Bdg9/RoboticsJawArduino/report/Conclusion.tex

\section{Conclusion}

This project presented the design and development of a novel chewing robot capable of reproducing jaw motions using a Stewart platform. 
The mechanical design, control system, and data processing pipeline were developed with scalability and modularity in mind, laying the 
groundwork for a more complete biomimetic mastication system.

The robot successfully replicates simplified human jaw trajectories using motion capture data and demonstrates the ability to generate average chewing forces. 
The inclusion of force sensing enables 3D distributed force feedback and basic safety mechanisms.
The modular control system and mechanical design allow for future integration of additional features, such as a tongue, saliva 
module, or esophagus.

Despite these achievements, the robot in its current form is not yet capable of full chewing functionality. Limitations in mechanical compliance, 
control accuracy, sensing precision, and teeth design prevent accurate and robust reproduction of natural mastication. Additionally, the current 
motion capture methodology introduces errors that limit the fidelity of recorded trajectories.

Nonetheless, the system serves as a strong foundation for future work. Improvements in control strategy, sensing, compliance, and anatomical 
fidelity—combined with more accurate motion datasets—will enable the robot to more closely replicate the biomechanics of human chewing.
