Bdg9/RoboticsJawArduino/plots_generation/actuator_rms_errors.png

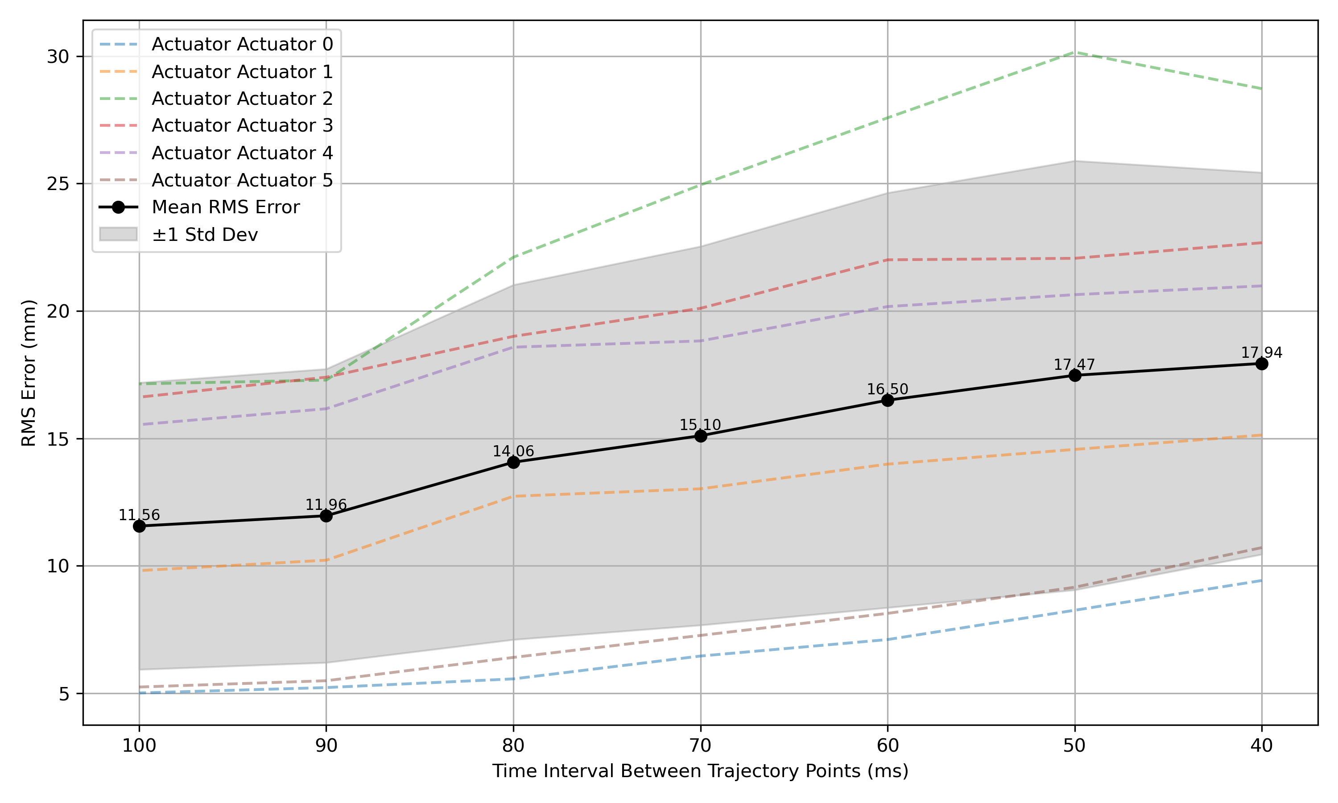
plots_generation/actuator_rms_errors.png
