Bdg9/RoboticsJawArduino/plots_generation/trajectory_plot_before.png

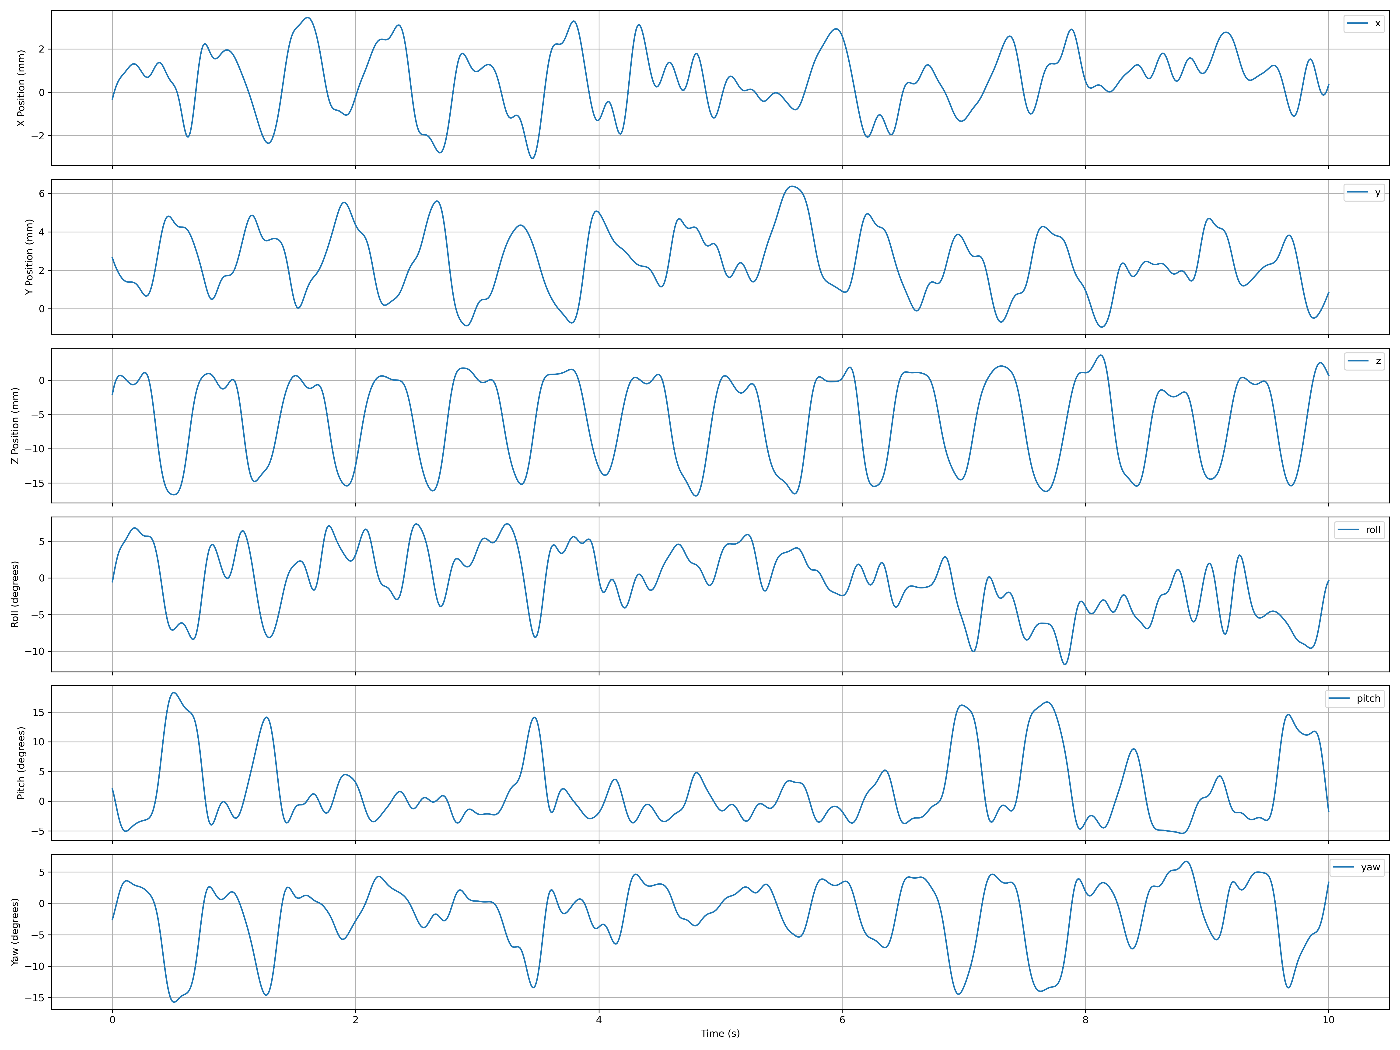
plots_generation/trajectory_plot_before.png
