Bdg9/RoboticsJawArduino/report/figures/6dof_jaw.jpg

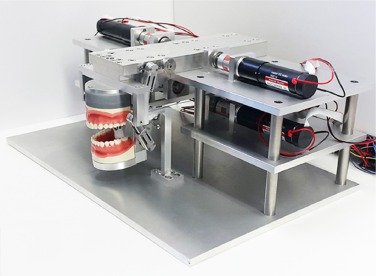
report/figures/6dof_jaw.jpg
