Bdg9/RoboticsJawArduino/report/figures/actuator_1_trajectories.png

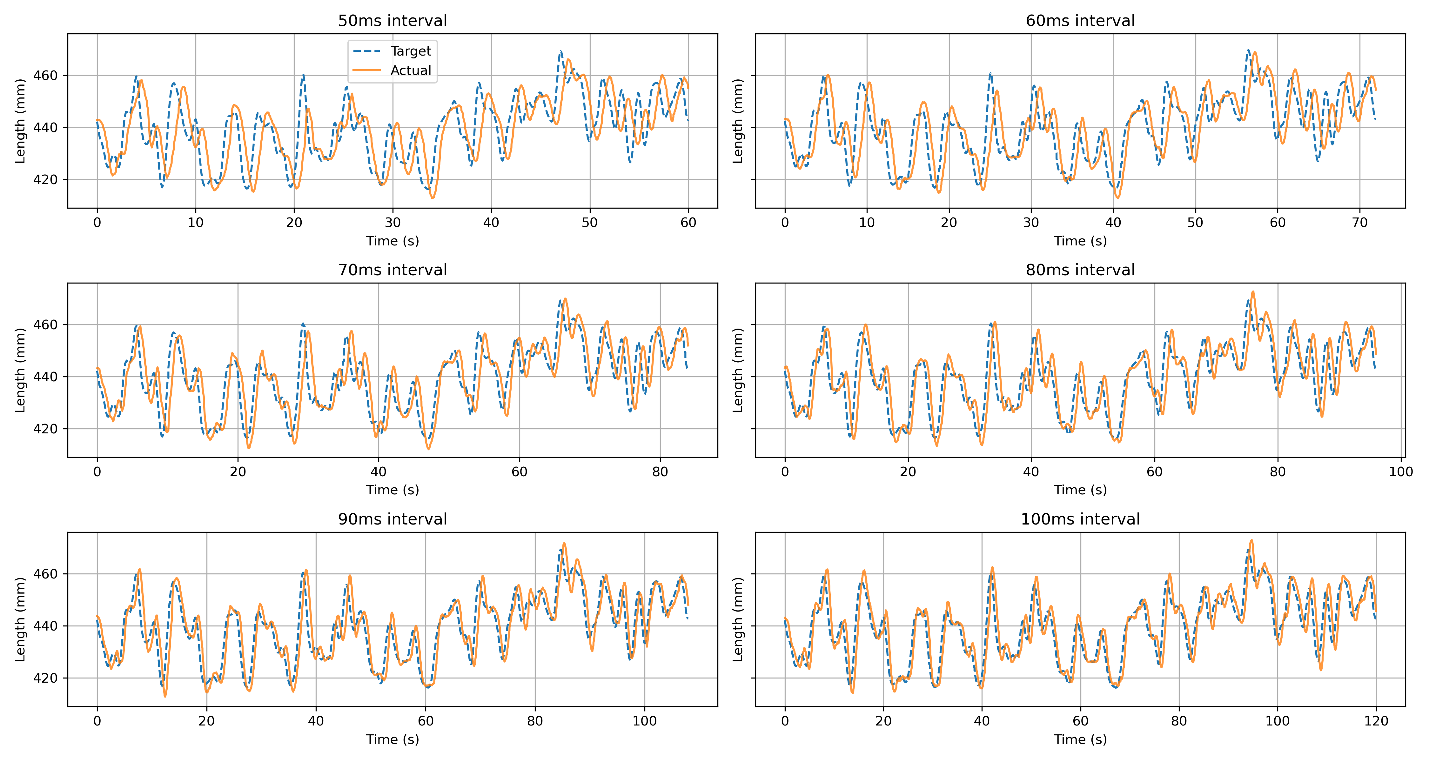
report/figures/actuator_1_trajectories.png
