Bdg9/RoboticsJawArduino/report/figures/actuator_4_trajectories.png

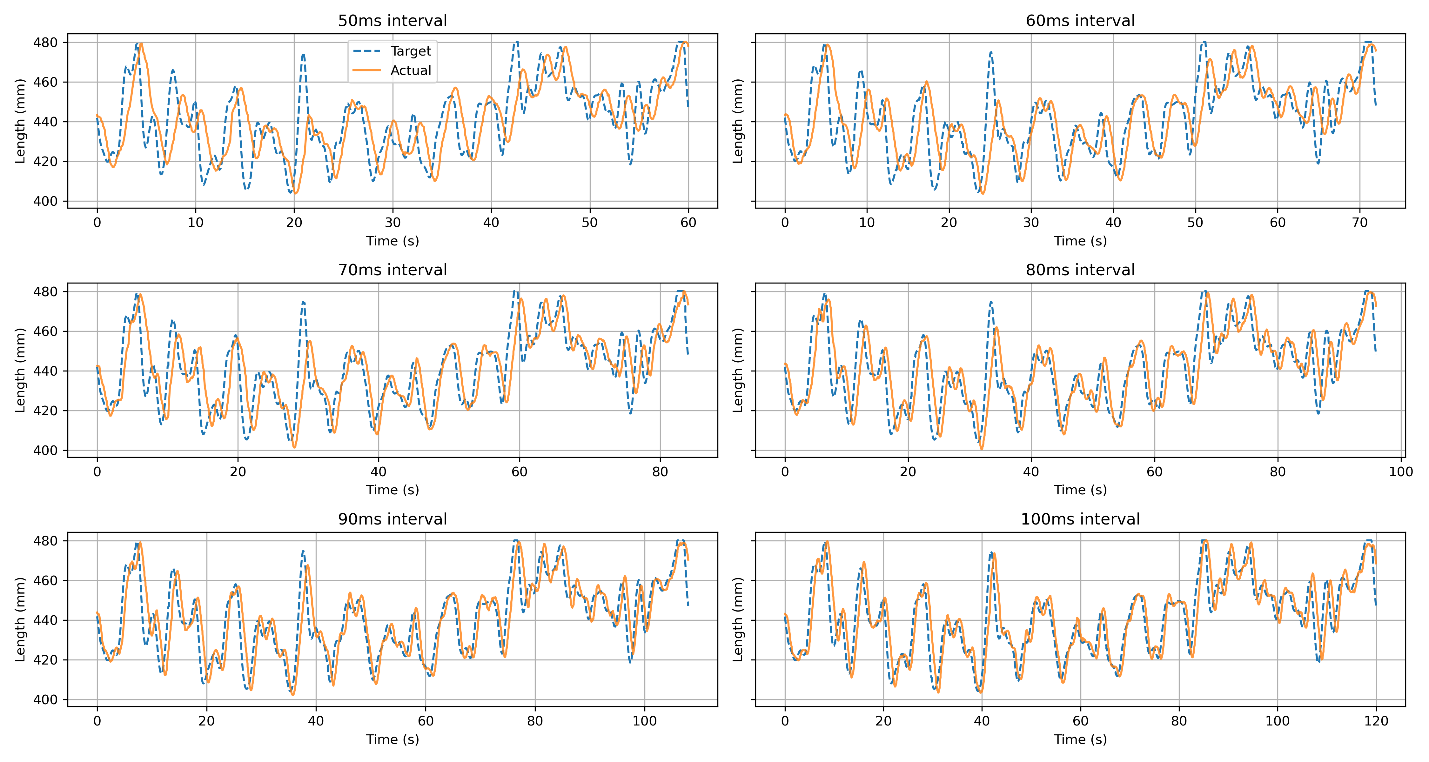
report/figures/actuator_4_trajectories.png
