Bdg9/RoboticsJawArduino/report/figures/actuator_5_trajectories.png

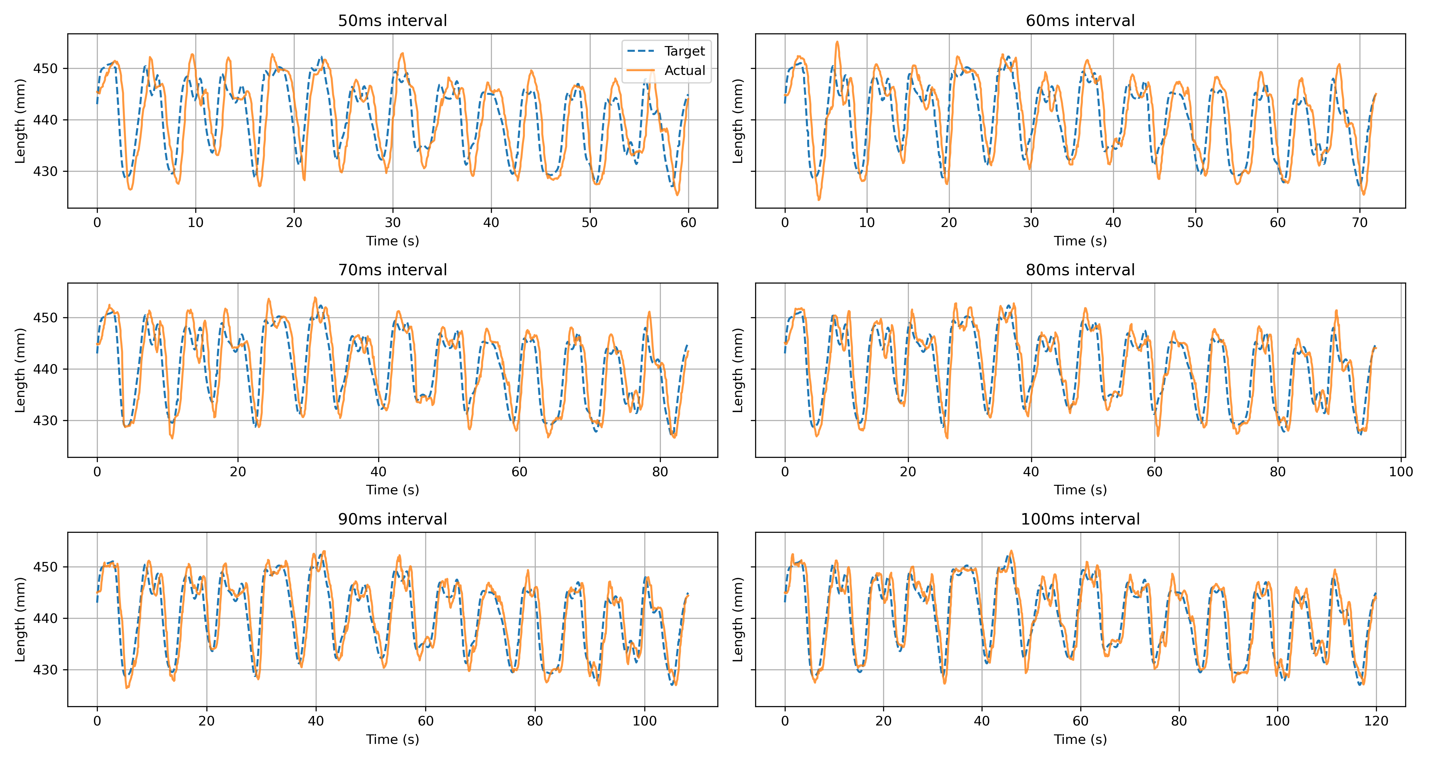
report/figures/actuator_5_trajectories.png
