Bdg9/RoboticsJawArduino/report/figures/ForceDistribution2.png

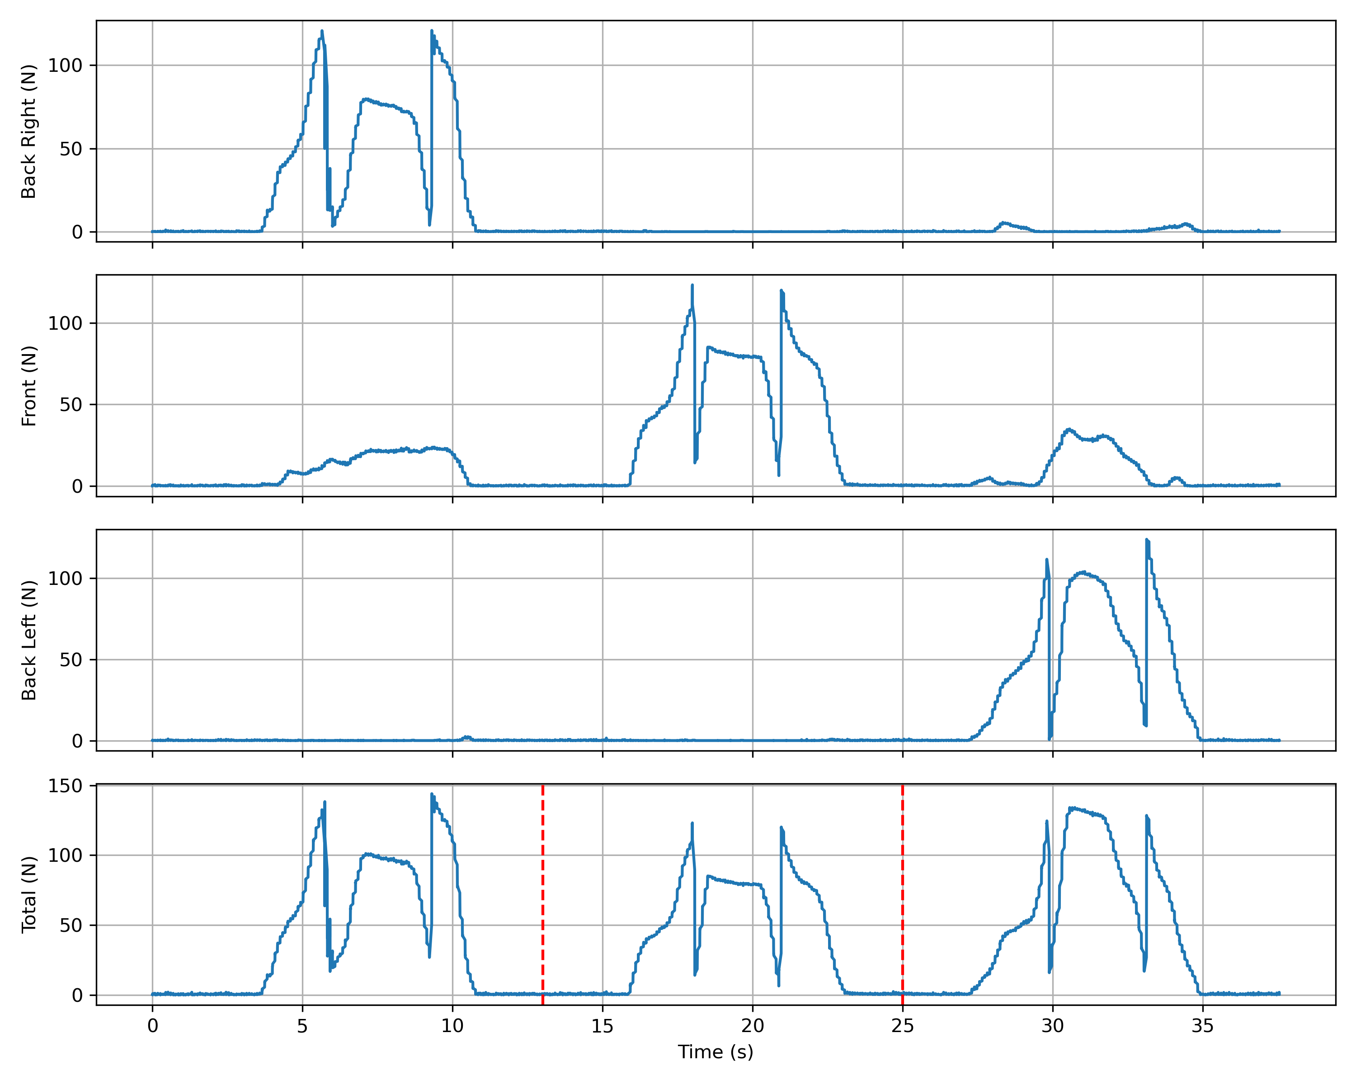
report/figures/ForceDistribution2.png
