Bdg9/RoboticsJawArduino/report/figures/ForceDistribution.png

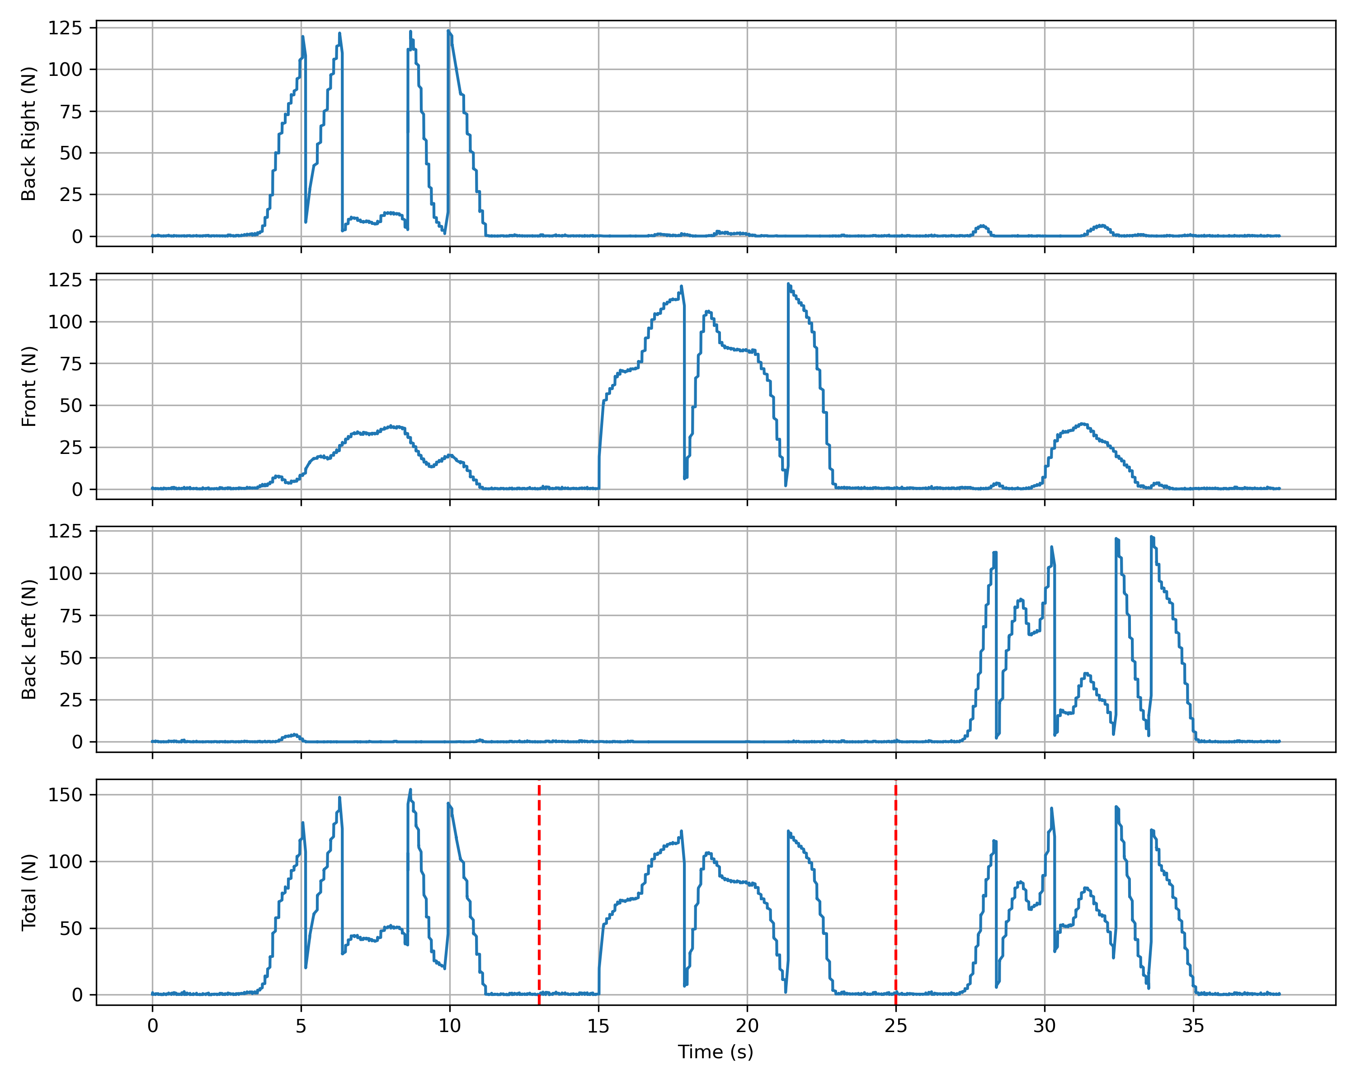
report/figures/ForceDistribution.png
