Bdg9/RoboticsJawArduino/report/figures/ForceDistribution_tpu.png

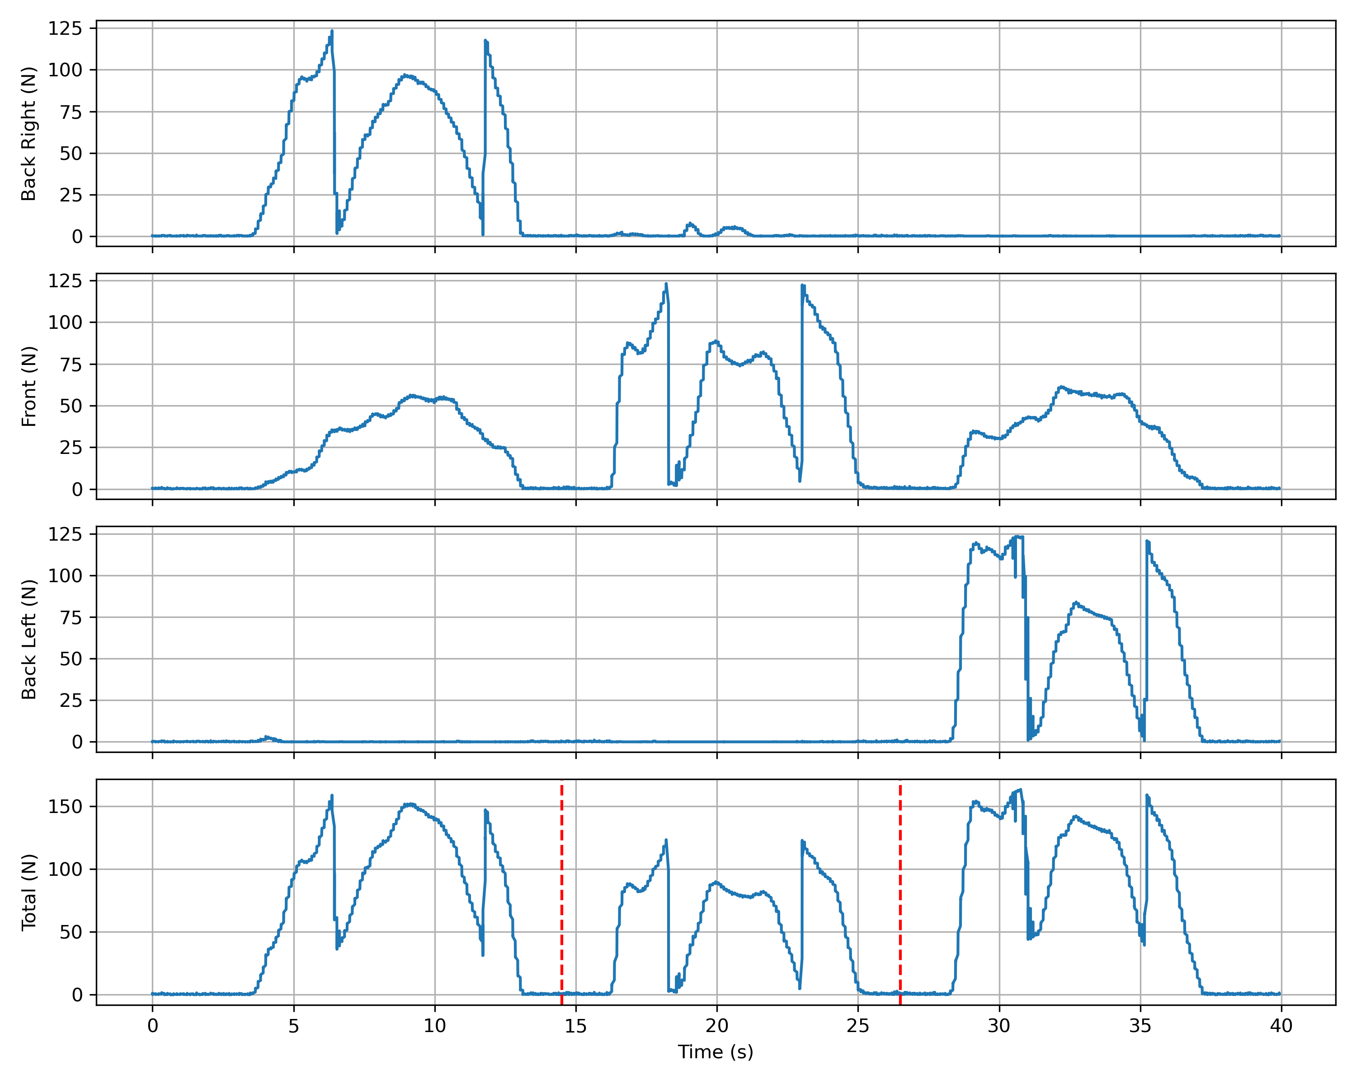
report/figures/ForceDistribution_tpu.png
