Bdg9/RoboticsJawArduino/report/figures/linear_stewart_platform.png

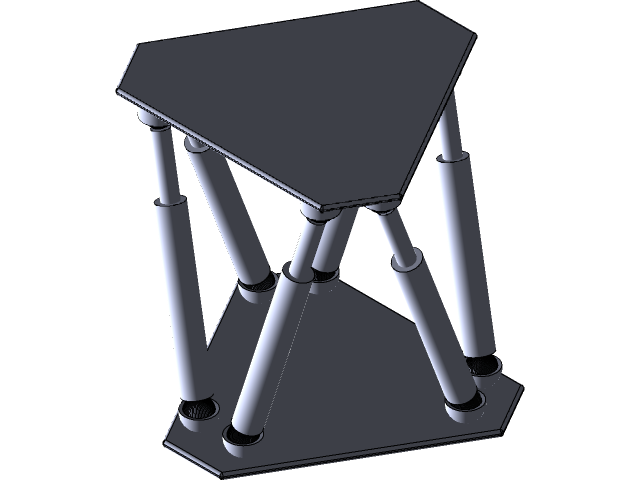
report/figures/linear_stewart_platform.png
