Bdg9/RoboticsJawArduino/report/figures/lower_jaw.png

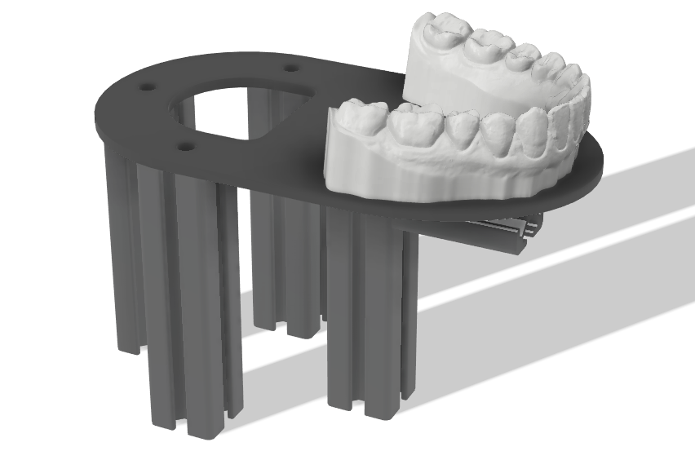
report/figures/lower_jaw.png
