Bdg9/RoboticsJawArduino/report/figures/upper_jaw.png

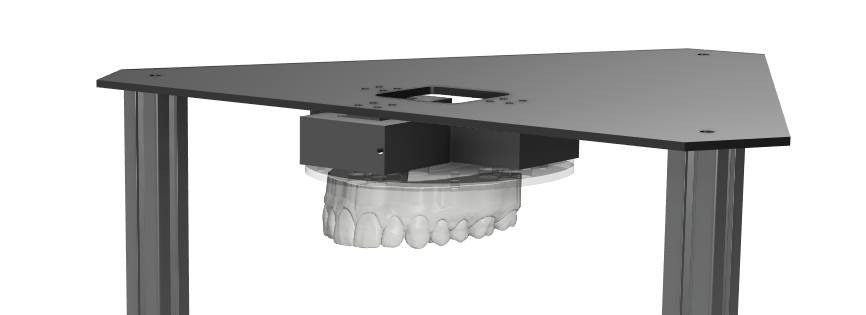
report/figures/upper_jaw.png
