Bdg9/RoboticsJawArduino/report/figures/upper_jaw_close_up.png

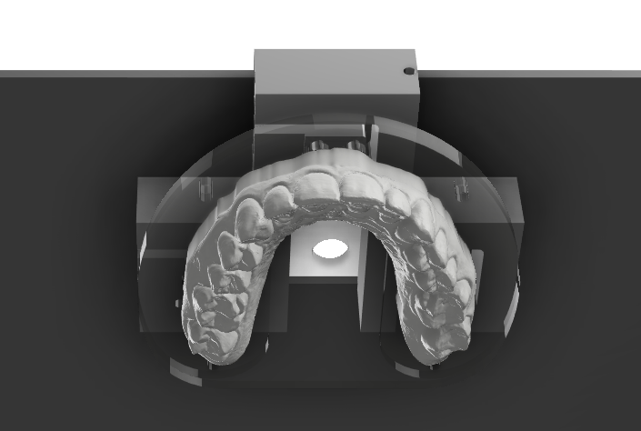
report/figures/upper_jaw_close_up.png
