Bdg9/RoboticsJawArduino/report/figures/x_vs_z_position.png

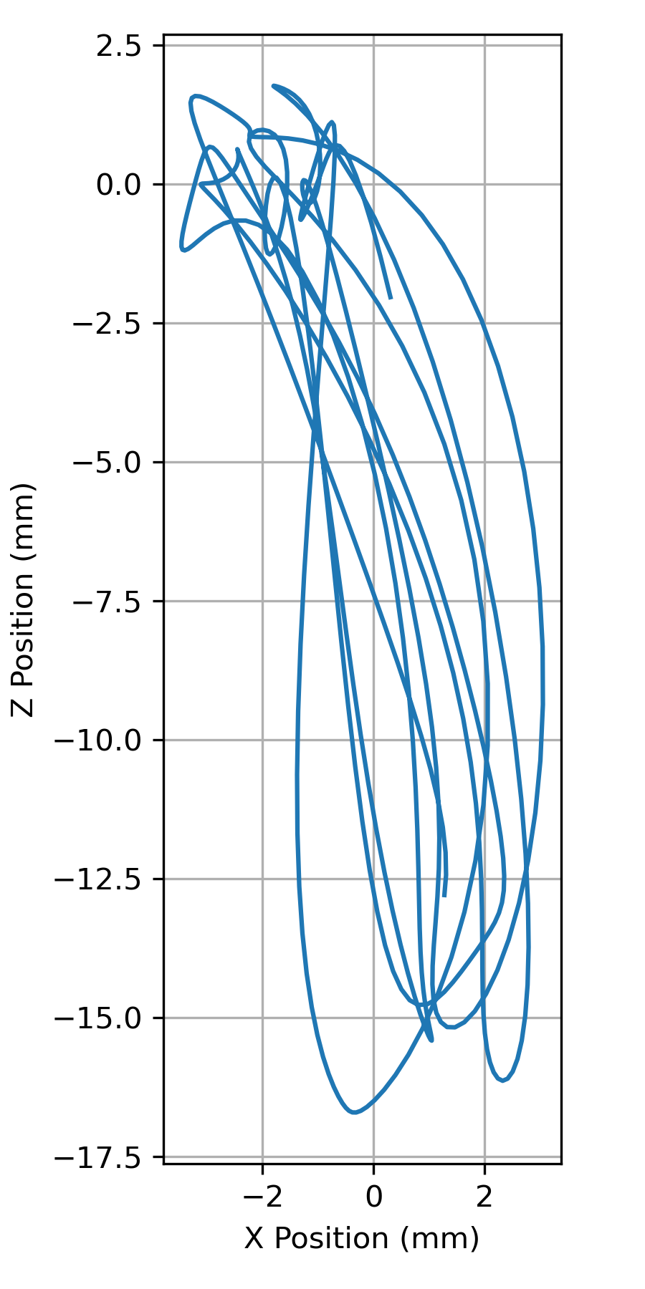
report/figures/x_vs_z_position.png
