Bdg9/RoboticsJawArduino/report/figures/y_vs_z_position.png

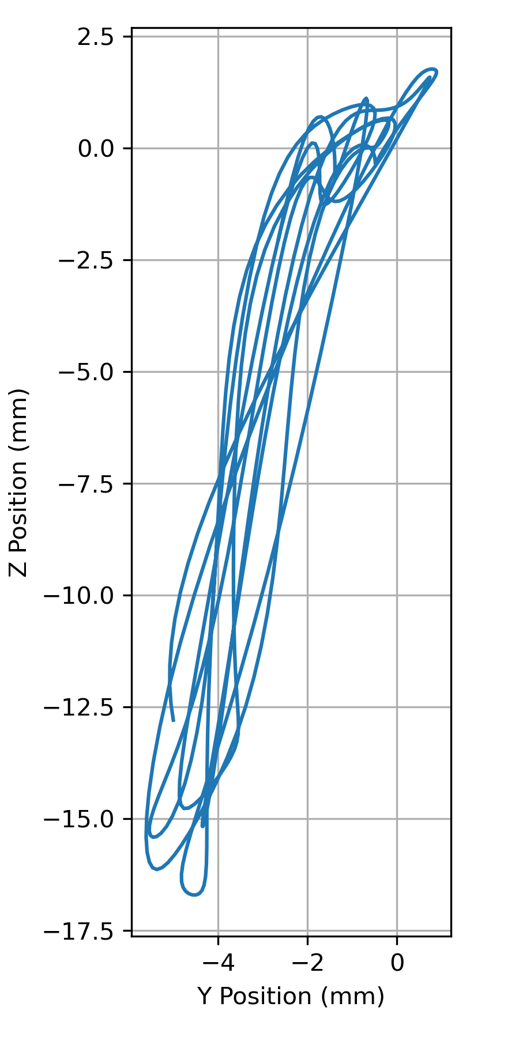
report/figures/y_vs_z_position.png
