Bdg9/RoboticsJawArduino/video_pic_real_robot/IMG_20250619_143249.jpg

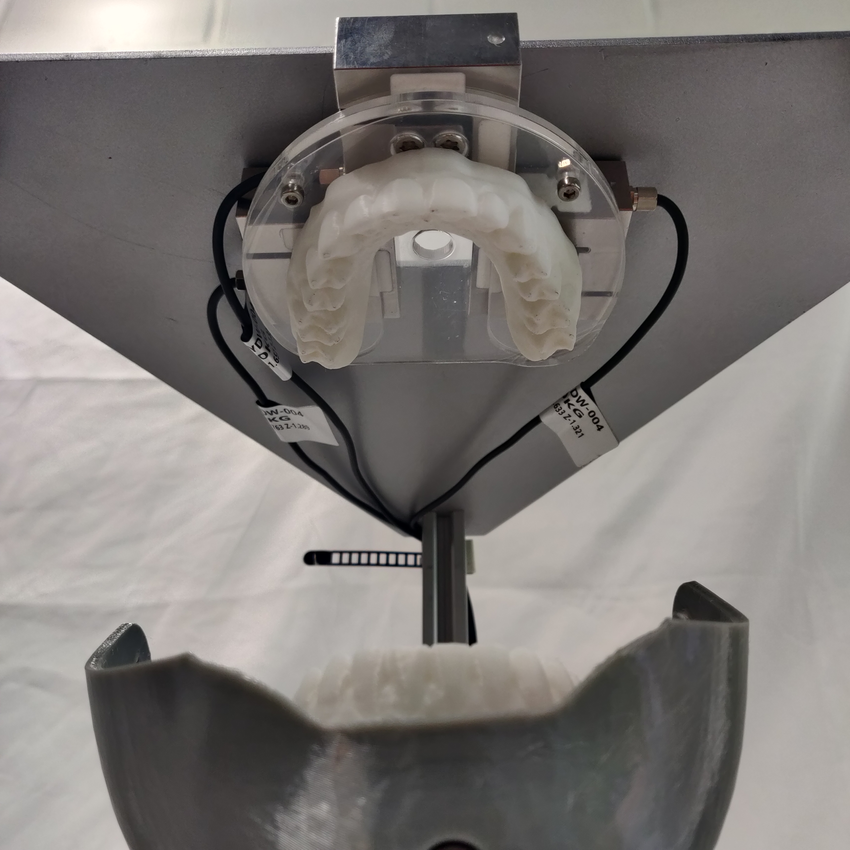
video_pic_real_robot/IMG_20250619_143249.jpg
