Bdg9/RoboticsJawArduino/Results/ExpMovingAverage/lengths_plot_alpha_01.png

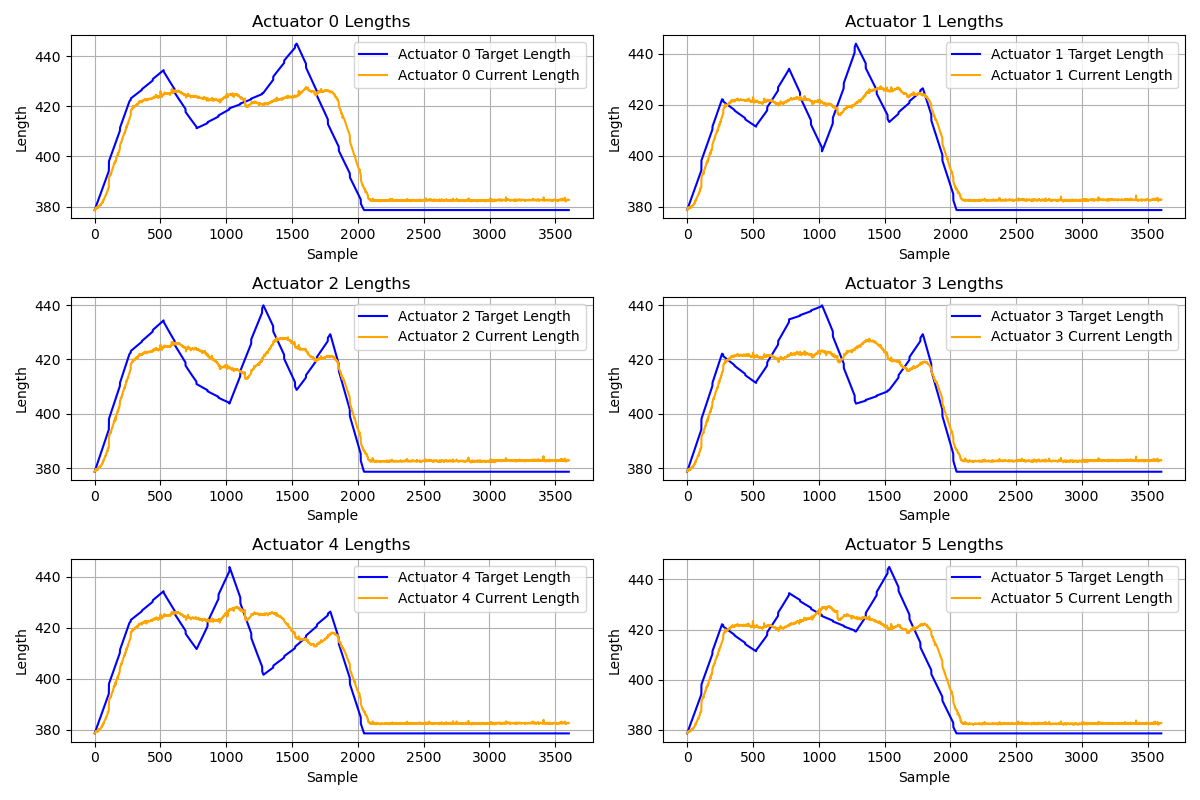
Results/ExpMovingAverage/lengths_plot_alpha_01.png
