Bdg9/RoboticsJawArduino/Results/ExpMovingAverage/lengths_plot_alpha_02.png

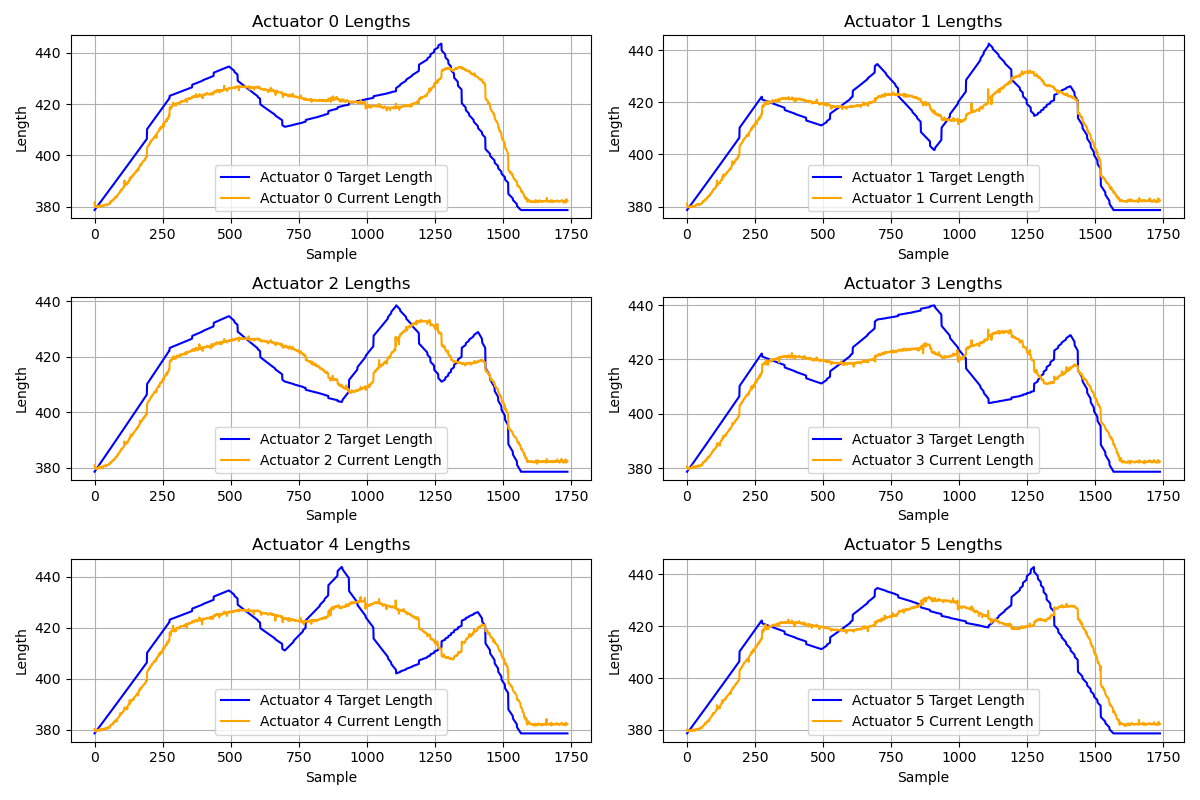
Results/ExpMovingAverage/lengths_plot_alpha_02.png
