Bdg9/RoboticsJawArduino/Results/ExpMovingAverage/lengths_plot_alpha_03.png

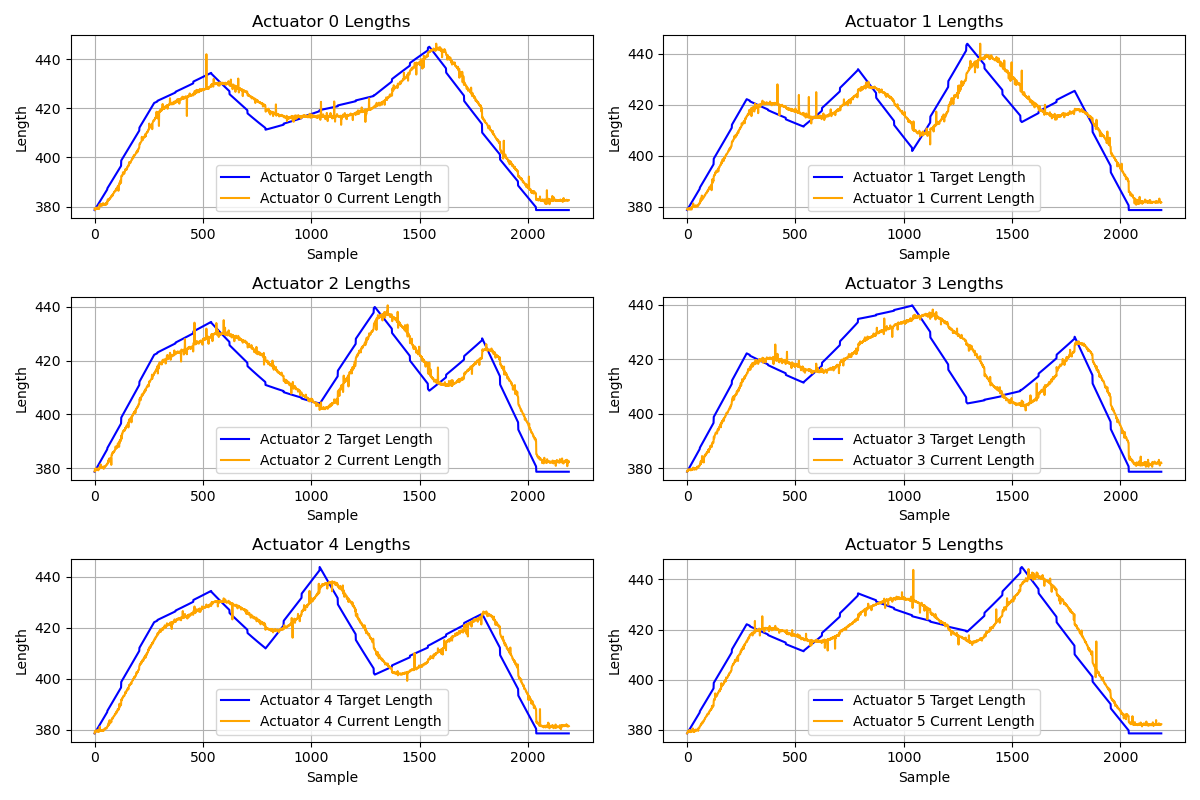
Results/ExpMovingAverage/lengths_plot_alpha_03.png
