Bdg9/RoboticsJawArduino/main/Trajectory.cpp

#include "Trajectory.h"

template <typename T>
T clamp(const T& value, const T& min, const T& max) {
    if (value < min) {
        Serial.print("Warning: Value ");
        Serial.print(value);
        Serial.print(" is below minimum ");
        Serial.println(min);
        return min;
    } else if (value > max) {
        Serial.print("Warning: Value ");
        Serial.print(value);
        Serial.print(" is above maximum ");
        Serial.println(max);
        return max;
    }
    return value;
}

Trajectory::Trajectory(unsigned long fixedInterval) : count(0), fixedInterval(fixedInterval) {}

bool Trajectory::addWaypoint(Pose& pose) {
    // pose.roll = degrees2rad(pose.roll); // Convert roll, pitch, and yaw from degrees to radians.
    // pose.pitch = degrees2rad(pose.pitch);
    // pose.yaw = degrees2rad(pose.yaw);
    // Validate that the pose is within the allowed limits.
    if( pose.x < MIN_X || pose.x > MAX_X ||
        pose.y < MIN_Y || pose.y > MAX_Y ||
        pose.z < MIN_Z || pose.z > MAX_Z ||
        pose.roll < MIN_ROLL || pose.roll > MAX_ROLL ||
        pose.pitch < MIN_PITCH || pose.pitch > MAX_PITCH ||
        pose.yaw < MIN_YAW || pose.yaw > MAX_YAW) {
        Serial.println("Error: Pose out of bounds.");
        return false;
    }
    if(count >= MAX_POINTS) {
        Serial.println("Error: Maximum number of waypoints reached.");
        return false;
    }
    // Compute time using fixed interval. First waypoint at time 0.
    unsigned long time = count * fixedInterval;
    points[count++] = {pose, time};
    return true;
}

// Load trajectory points from a CSV file. Each line should contain: x,y,z,roll,pitch,yaw.
bool Trajectory::loadFromCSV(const String &filename) {
    String fullPath = SD_ROOT + filename;
    File dataFile = SD.open(fullPath.c_str());
    if (!dataFile) {
        Serial.println("Failed to open file.");
        return false;
    }

    // Reset current trajectory.
    count = 0;

    Serial.println("Reading file content:");

    // Skip the header line with column names.
    if(dataFile.available()) {
        dataFile.readStringUntil('\n');
    }
    
    while (dataFile.available()) {
        String line = dataFile.readStringUntil('\n');
        if (line.length() == 0) continue; // Skip empty lines

        // Expecting each line: x,y,z,roll,pitch,yaw
        int pos1 = line.indexOf(',');
        int pos2 = line.indexOf(',', pos1 + 1);
        int pos3 = line.indexOf(',', pos2 + 1);
        int pos4 = line.indexOf(',', pos3 + 1);
        int pos5 = line.indexOf(',', pos4 + 1);
        if (pos1 == -1 || pos2 == -1 || pos3 == -1 || pos4 == -1 || pos5 == -1) {
            Serial.println("Error: Malformed CSV line.");
            continue;
        }

        Pose pose;
        String token;
        token = line.substring(0, pos1);
        pose.x = token.toFloat();
        token = line.substring(pos1 + 1, pos2);
        pose.y = token.toFloat();
        token = line.substring(pos2 + 1, pos3);
        pose.z = token.toFloat();
        token = line.substring(pos3 + 1, pos4);
        pose.roll = token.toFloat();
        token = line.substring(pos4 + 1, pos5);
        pose.pitch = token.toFloat();
        token = line.substring(pos5 + 1);
        pose.yaw = token.toFloat();

        // Serial.print("Read pose: ");
        // Serial.print("x: "); Serial.print(pose.x); Serial.print(", ");
        // Serial.print("y: "); Serial.print(pose.y); Serial.print(", ");
        // Serial.print("z: "); Serial.print(pose.z); Serial.print(", ");
        // Serial.print("roll: "); Serial.print(pose.roll); Serial.print(", ");
        // Serial.print("pitch: "); Serial.print(pose.pitch); Serial.print(", ");
        // Serial.print("yaw: "); Serial.println(pose.yaw);

        // Add the waypoint. If adding fails, break.
        if (!addWaypoint(pose)) {
            Serial.println("Error: Failed to add waypoint from CSV.");
            break;
        }
    }
    dataFile.close();
    return true;
}

Pose Trajectory::getPose(unsigned long currentTime) {
    if(count == 0) return {0,0,0,0,0,0};
    if(currentTime >= points[count-1].time) {
        // If current time is beyond the last point, return the initial pose.
        return {0,0,0,0,0,0};
    }
    if(currentTime <= points[0].time) return points[0].pose;
    if(count < 4){
        for(int i = 1; i < count; i++) {
            if(currentTime < points[i].time) {
                float t = float(currentTime - points[i-1].time) / (points[i].time - points[i-1].time);
                Pose a = points[i-1].pose, b = points[i].pose;
                Pose interpolatedPose = {
                    a.x + t * (b.x - a.x),
                    a.y + t * (b.y - a.y),
                    a.z + t * (b.z - a.z),
                    a.roll + t * (b.roll - a.roll),
                    a.pitch + t * (b.pitch - a.pitch),
                    a.yaw + t * (b.yaw - a.yaw)
                };
                // Clamp the interpolated pose to the defined limits
                interpolatedPose = clampPose(interpolatedPose);

                return interpolatedPose;
            }
        }
    }else{
        // Locate the segment we’re inside (between points[i-1] and points[i])
        int i = 1;
        while (i < count && currentTime >= points[i].time) ++i;

        // Clamp i so that we have p(i-2) … p(i+1) available
        int i0 = std::max(0, i - 2);
        int i1 = std::max(0, i - 1);
        int i2 = std::min(count - 1, i);
        int i3 = std::min(count - 1, i + 1);

        // Normalised parameter 0‥1 inside the segment [points[i1], points[i2]]
        const unsigned long t0 = points[i1].time, t1 = points[i2].time;
        float t = static_cast<float>(currentTime - t0) / static_cast<float>(t1 - t0);

        const Pose &P0 = points[i0].pose;
        const Pose &P1 = points[i1].pose;
        const Pose &P2 = points[i2].pose;
        const Pose &P3 = points[i3].pose;

        Pose p {
            catmullRom(P0.x,    P1.x,    P2.x,    P3.x,    t),
            catmullRom(P0.y,    P1.y,    P2.y,    P3.y,    t),
            catmullRom(P0.z,    P1.z,    P2.z,    P3.z,    t),
            catmullRom(P0.roll, P1.roll, P2.roll, P3.roll, t),
            catmullRom(P0.pitch,P1.pitch,P2.pitch,P3.pitch,t),
            catmullRom(P0.yaw,  P1.yaw,  P2.yaw,  P3.yaw,  t)
        };

        // Clamp to operational limits (duplicates removed)
        p = clampPose(p);

        return p;
    }
    return points[count-1].pose;
}

Pose Trajectory::clampPose(const Pose& pose) {
    Pose clampedPose;
    clampedPose.x = clamp(pose.x, MIN_X, MAX_X);
    clampedPose.y = clamp(pose.y, MIN_Y, MAX_Y);
    clampedPose.z = clamp(pose.z, MIN_Z, MAX_Z);
    clampedPose.roll = clamp(pose.roll, MIN_ROLL, MAX_ROLL);
    clampedPose.pitch = clamp(pose.pitch, MIN_PITCH, MAX_PITCH);
    clampedPose.yaw = clamp(pose.yaw, MIN_YAW, MAX_YAW);
    return clampedPose;
}

float Trajectory::catmullRom(float p0, float p1, float p2, float p3, float t)
{
    float t2 = t * t;
    float t3 = t2 * t;
    return 0.5f * (
          2.0f * p1
        + (p2 - p0) * t
        + (2.0f * p0 - 5.0f * p1 + 4.0f * p2 - p3) * t2
        + (-p0 + 3.0f * p1 - 3.0f * p2 + p3) * t3
    );
}

void Trajectory::printPose(const Pose& pose) {
    Serial.print("Pose: "); Serial.print("x: "); Serial.print(pose.x); Serial.print(", ");
    Serial.print("y: "); Serial.print(pose.y); Serial.print(", ");
    Serial.print("z: "); Serial.print(pose.z); Serial.print(", ");
    Serial.print("roll: "); Serial.print(pose.roll); Serial.print(", ");
    Serial.print("pitch: "); Serial.print(pose.pitch); Serial.print(", ");
    Serial.print("yaw: "); Serial.print(pose.yaw); Serial.print(", ");
    Serial.print("time: "); Serial.println(millis());
}

void Trajectory::printPoints() {
    Serial.println("Trajectory Points:");
    int limit_print = count < 20 ? count : 20; // Limit to 20 points for printing
    for(int i = 0; i < limit_print; i++) {
        Serial.print("Point "); Serial.print(i); Serial.print(": ");
        Serial.print("Time: "); Serial.print(points[i].time); Serial.print(", ");
        Serial.print("Pose: ("); Serial.print(points[i].pose.x); Serial.print(", ");
        Serial.print(points[i].pose.y); Serial.print(", ");
        Serial.print(points[i].pose.z); Serial.print(", ");
        Serial.print(points[i].pose.roll); Serial.print(", ");
        Serial.print(points[i].pose.pitch); Serial.print(", ");
        Serial.print(points[i].pose.yaw); Serial.println(")");
    }
}

void Trajectory::setFixedInterval(unsigned long interval) {
    fixedInterval = interval;
}

int Trajectory::getFixedInterval() const {
    return fixedInterval;
}
