Bdg9/RoboticsJawArduino/main/StewartPlatform.h

#ifndef STEWART_PLATFORM_H
#define STEWART_PLATFORM_H

#include "Actuator.h"
#include "Kinematics.h"

class StewartPlatform {
public:
    StewartPlatform();
    void begin();
    void moveToPose(const Pose& pose, bool absolute = false);
    void moveToHomePose() {
        moveToPose(kin.getHomePose(), true); // Move to home pose with absolute position kinematics
    }
    void stop();
    bool update(bool verbose=false);
    bool calibrateActuators(bool fullCalibration, bool debug=false);
    void setHomePose(const Pose& pose) {
        kin.setHomePose(pose); 
    }
    Pose getHomePose() const {
        return kin.getHomePose();
    }
private:
    CD74HC4067 pot_mux;
    Actuator* actuators[6];
    float targetLengths[6];
    Kinematics kin;
};

#endif // STEWART_PLATFORM_H
