Bdg9/RoboticsJawArduino/(commit log)

2025-03-27 updated motor driver
2025-03-27 calibrate actuators
2025-04-03 new test code and updated calibration
2025-04-03 update failing error added
    [Actuator.cpp, Actuator.h, StewartPlatform.cpp, main.ino]
2025-04-07 fixed bugs to make trajectory control work
    [Actuator.cpp, Actuator.h, Config.h, StewartPlatform.cpp, StewartPlatform.h, Trajectory.cpp, Trajectory.h, Utils.h]
2025-04-07 corrected driver direction
2025-04-08 x axis is time
2025-04-08 fixed plots and changed pwm freq to not hear thehigh pitch noise from motors
    [Actuator.cpp, Config.h, MotorDriver.cpp, Trajectory.cpp]
2025-05-16 test for calibration of workspace
2025-05-23 actuator calib from sd card
2025-05-28 calibration min only implemented
2025-05-29 working calibration yay + state machine calib state finished
